SavageBeef/ESP32-Tank/(commit log)

2025-05-04 Added Arduino code.
2025-05-09 Add Schematic Diagram.
2025-05-11 Resolve issue with LED widget.
    [ESP32_WiFi_Tank_GitHub.ino]
2025-09-14 Added battery voltage and percentage.
2025-09-21 Fix issue where blynk prevents Arduino OTA from working.
    [ESP32_WiFi_Tank_GitHub.ino]
2025-09-29 bug(ultrasonic): reset the joystick to neutral when ultrasonic is engaged.
    [ESP32_WiFi_Tank_GitHub.ino]
2025-09-30 fix(Battery): Apply calibration factor for accurate battery voltage
    [ESP32_WiFi_Tank_GitHub.ino]
2025-10-01 fix: Ultrasonic sensor logic for persistent obstacle stop
    The HC-SR04 sensor logic is updated to maintain a stopped state after an obstacle is detected, regardless of the joystick's forward position. Movement can only be resumed by turning the sensor OFF, which acts as a manual reset.
    [ESP32_WiFi_Tank_GitHub.ino]
2025-10-01 feat(Hardware): Finalize voltage divider values and system calibration
    Replaced the nominal voltage divider resistors with the final measured values (R1=41860Ω, R2=9989Ω). This increases the ratio to 5.1906, ensuring the max 16.8V battery voltage scales safely below the 3.3V ADC limit.
    Updated the software calibration factor to 1.054 (14.93V/14.16V) to correct for all remaining ADC and Vref inaccuracies.
    [ESP32_WiFi_Tank_GitHub.ino]
2025-10-05 Adjust battery calibration factor and sample size
2025-10-06 feat(Ultrasonic): Allow user to define custom obstacle distance limit
    Adds a Numeric Input widget to the Blynk app, enabling users to dynamically set the threshold distance for the ultrasonic sensor before the vehicle stops.
2025-10-13 Fix: Eliminate motor dead zone using PWM mapping
    [ESP32_WiFi_Tank_GitHub.ino]
2025-10-19 Fix(Ultrasonic): Changes comparison operators (==) to digitalWrite() calls to properly control the currentToUSonic pin.
    [ESP32_WiFi_Tank_GitHub.ino]
2025-10-20 Added a function template that prints to both Serial and WebSerial simultaneously.
2025-10-21 Feat: Implement Strict Directional Transition Guard (Dead-Zone Lock)
    Prevents accidental, high-speed reversals (e.g., FWD-Left to REV-Left) caused by joystick rotation or slips along the side edges, significantly improving control safety.
    This guard enforces the rule that the tank must return to the absolute center point (Neutral) before switching between any Forward and Reverse state.
    Key Changes:
    Dead-Zone Lock: Implemented logic within BLYNK_WRITE(V5) that freezes the directional state (lastYRegion) when the joystick is in the narrow X-axis neutral band (minNeuRange to maxNeuRange). This ensures the transition guard remains armed, blocking attempts to switch direction while rotating.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
    [ESP32_WiFi_Tank_GitHub.ino]
2025-11-28 feat(WebSerial): Add printf functionality for formatted output
2026-01-20 feat: Implement dual-stage provisioning system for WiFi and Blynk configuration
    Add comprehensive WiFi and Blynk credential management system with intelligent
    fallback provisioning. This implementation improves user experience by providing
    context-aware configuration options and reducing reconfiguration burden.
    Features:
    ---------
    • Combined WiFi + Blynk provisioner
    - Launches on initial WiFi connection failure
    - Presents unified interface for configuring WiFi credentials and Blynk settings
    - Automatically parses server:port format for Blynk configuration
    - Supports custom Blynk server and port customization
    • Blynk-only provisioner with persistent settings
    - Launches on subs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
    [ESP32_WiFi_Tank_GitHub.ino]
2026-02-18 feat: polish blynk provisioning UI
    - Added 'success.html' page to provide user feedback during restart
    - Implemented error handling via URL redirects and Bootstrap alerts
    - Fixed 2-second restart delay to ensure web response delivery
    [ESP32_WiFi_Tank_GitHub.ino]
